yismailsaadelgedawy/PROJ515/Low noise small signal amplifier.asc

C1: cap; 3.2µ
C2: cap; 56p
C3: cap; 12.1µ
C4: cap; 100n
C5: cap; 10µ
C16: cap; 10µ
C17: cap; 30n
C18: cap; 30n
C19: cap; 30n
C20: cap; 30n
C21: cap; 30n
C22: cap; 30n
C23: cap; 100n
C24: cap; 100n
C25: cap; 10µ
C26: cap; 1µ
C27: cap; 1.5n
C28: cap; 1.5n
C29: cap; 1.5n
C30: cap; 1.5n
C31: cap; 1.5n
C32: cap; 1.5n
C33: cap; 1µ
C34: cap; 1µ
C35: cap; 1µ
C36: cap; 1µ
C37: cap; 0.1µ
C38: cap; 10n
C39: cap; 10n
C40: cap; 10n
C41: cap; 10n
C42: cap; 10n
C43: cap; 10n
C44: cap; 1µ
C45: cap; 1µ
C46: cap; 2.2n
C47: cap; 430p
C48: cap; 2.2n
C49: cap; 10n
C50: cap; 2.2n
C51: cap; 10n
D1: diode; RBR2LAM60A
D2: diode; RBR2LAM60A
D3: diode; RBR2LAM60A
R1: res; 100k
R2: res; 5k
R3: res; 100k
R4: res; 100k
R5: res; 2.5k
R6: res; 100k
R15: res; 100k
R16: res; 100k
R17: res; 4.99k
R18: res; 200k
R19: res; 10k
R20: res; 173k
R21: res; 106k
R22: res; 1.42k
R23: res; 346k
R24: res; 2.06k
R25: res; 202k
R26: res; 127k
R27: res; 2.47k
R28: res; 242k
R29: res; 191k
R30: res; 2.61k
R31: res; 210k
R32: res; 2.87k
R33: res; 10k
R34: res; 15.2k
R35: res; 1Meg
R36: res; 132k
R37: res; 70.3k
R38: res; 1.15k
R39: res; 264k
R40: res; 1.6k
R41: res; 156k
R42: res; 87k
R43: res; 1.98k
R44: res; 193k
R45: res; 37.1k
R46: res; 499
R47: res; 41.8k
R48: res; 562
R49: res; 200k
R50: res; 127k
R51: res; 42k
R52: res; 15.2k
R53: res; 1Meg
R54: res; 100k
R55: res; 175k
R56: res; 6.54k
R57: res; 255k
R58: res; 2.24k
R59: res; 387k
R60: res; 80.8k
R61: res; 4.31k
R62: res; 744k
R63: res; 35.3k
R64: res; 108k
R65: res; 52.5k
R67: res; 200k
R68: res; 15.2k
R69: res; 1Meg
R70: res; 80k
R71: res; 160k
R72: res; 90.4k
R73: res; 318k
R74: res; 145k
U2: MAX44246
U3: MAX9636
U5: AD8031
U6: MAX9638
U7: MAX9638
U8: MAX9638
U9: LT1018
U10: MAX9638
U11: MAX9638
U12: MAX9638
U13: LT1018
U14: MAX9638
U15: MAX9638
U16: MAX9638
U17: MAX9638
U18: MAX9638
U19: MAX9638
U20: LT1018
U21: MAX9638
U22: MAX9638
U23: MAX9638
U24: MAX9638
U25: MAX9638
U26: MAX9638
U27: MAX9638
V1: voltage; SINE(0 1 600); AC 1
V2: voltage; ""; AC 1
V4: voltage; SINE(0 1m 500); AC 1
V5: voltage; 3.3
Named nets: VA, Vin, 0, Vcc, Vref, Vout2, Venv2, Comp2out, env2_out, Vout, Venv1, Comp1out, Cref, Cref2, ADC_out, Vout3, Vout4, Vout5
.ac dec 10000 10 1000000
.tran 50m
Source and reference
U9 is TI TLV3201/2 comparator
U12 is TI TLV3201/2 comparator
6.11 kHz bandpass trigger
Lowpass amplifier gain stage 1: 32 dB, total: 58.5 dB
240 Hz bandpass trigger
ADC amplifier
U9 is TI TLV3201/2 comparator
420 Hz bandpass trigger
800 Hz anti-aliasing
450 Hz anti-aliasing
