yismailsaadelgedawy/PROJ515/thermocouple_PCB.kicad_pcb

## KiCad design thermocouple_PCB.kicad_pcb (2025-03-26)

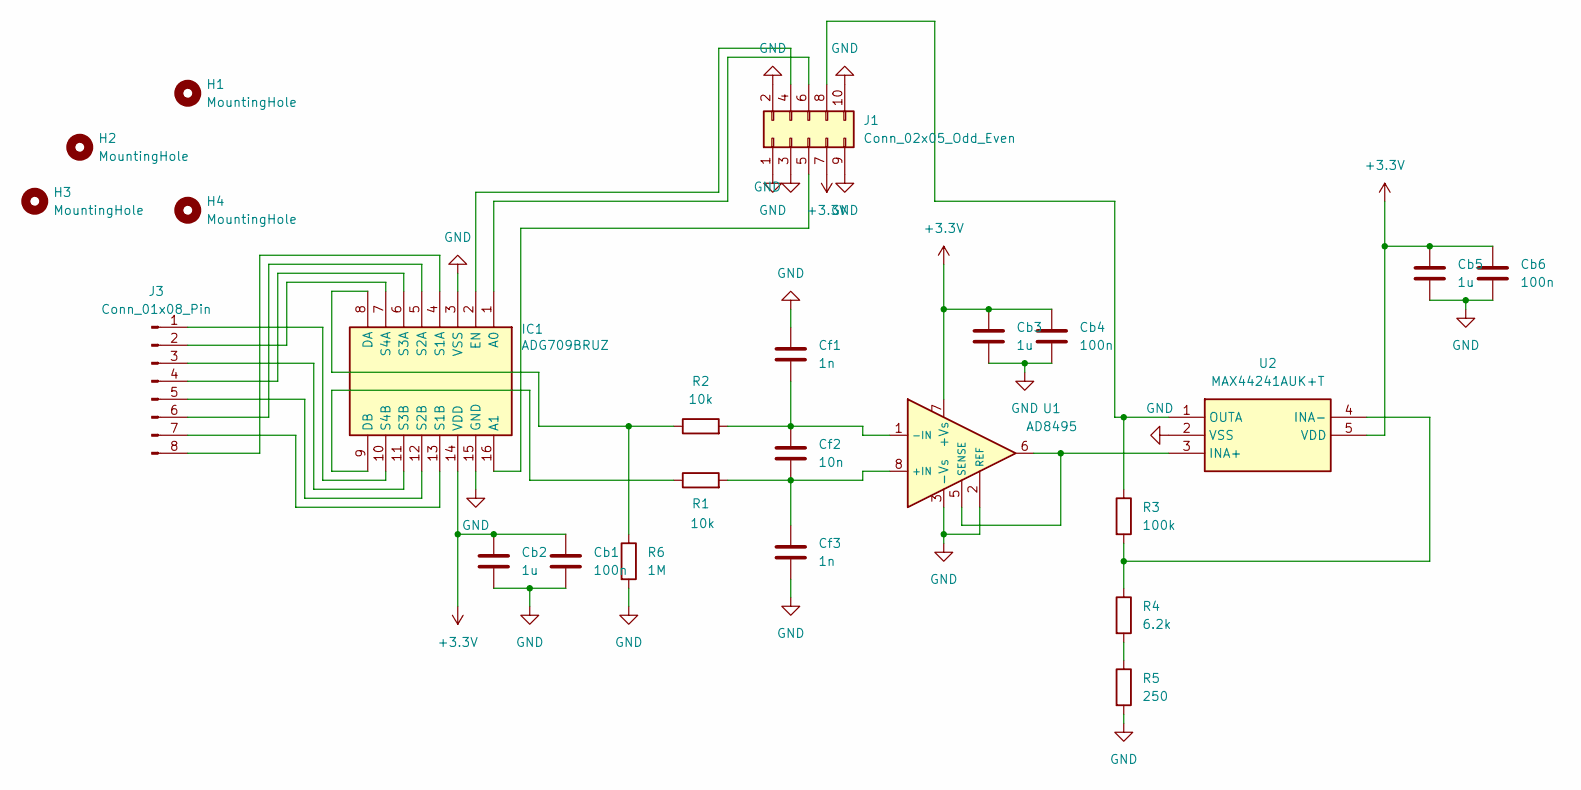
[picture p1: schematic thermocouple_PCB.kicad_sch]

Parts:
Cb1, Cb4, Cb6: 100n; C_0402_1005Metric
Cb2, Cb3, Cb5: 1u; C_0402_1005Metric
Cf1, Cf3: 1n; C_0603_1608Metric
Cf2: 10n; C_0603_1608Metric
H1, H2, H3, H4: MountingHole; MountingHole_2.2mm_M2_DIN965_Pad_TopBottom
IC1: ADG709BRUZ; TSSOP-16_4.4x5mm_P0.65mm; Manufacturer_Part_Number ADG709BRUZ; Mouser Part Number 584-ADG709BRUZ
J1: Conn_02x05_Odd_Even; PinHeader_2x05_P2.54mm_Horizontal
J3: Conn_01x08_Pin; PinHeader_1x08_P2.54mm_Horizontal
R1, R2: 10k; R_0402_1005Metric
R3: 100k; R_0402_1005Metric
R4: 6.2k; R_0603_1608Metric
R5: 250; R_0402_1005Metric
R6: 1M; R_0402_1005Metric
U1: AD8495; MSOP-8_3x3mm_P0.65mm
U2: MAX44241AUK+T; SOT-23-5; Manufacturer_Part_Number MAX44241AUK+T; Mouser Part Number 700-MAX44241AUK+T

Connections:
+3.3V: Cb1.1, Cb2.1, Cb3.1, Cb4.1, Cb5.1, Cb6.1, IC1.14 (VDD), J1.7, U1.7 (+Vs), U2.5 (VDD)
GND: Cb1.2, Cb2.2, Cb3.2, Cb4.2, Cb5.2, Cb6.2, Cf1.1, Cf3.2, IC1.3 (VSS), IC1.15 (GND), J1.1, J1.2, J1.3, J1.9, J1.10, R5.2, R6.2, U1.2 (REF), U1.3 (-Vs), U2.2 (VSS)
unnamed: IC1.1 (A0), J1.6
unnamed: IC1.16 (A1), J1.5
unnamed: IC1.8 (DA), R2.1, R6.1
unnamed: IC1.9 (DB), R1.1
unnamed: IC1.2 (EN), J1.4
unnamed: IC1.4 (S1A), J3.8
unnamed: IC1.13 (S1B), J3.7
unnamed: IC1.5 (S2A), J3.6
unnamed: IC1.12 (S2B), J3.5
unnamed: IC1.6 (S3A), J3.4
unnamed: IC1.11 (S3B), J3.3
unnamed: IC1.7 (S4A), J3.2
unnamed: IC1.10 (S4B), J3.1
unnamed: J1.8, R3.1, U2.1 (OUTA)
unnamed: R4.2, R5.1
unnamed: Cf2.2, Cf3.1, R1.2, U1.8 (+IN)
unnamed: Cf1.2, Cf2.1, R2.2, U1.1 (-IN)
unnamed: U1.5 (SENSE), U1.6, U2.3 (INA+)
unnamed: R3.2, R4.1, U2.4 (INA-)

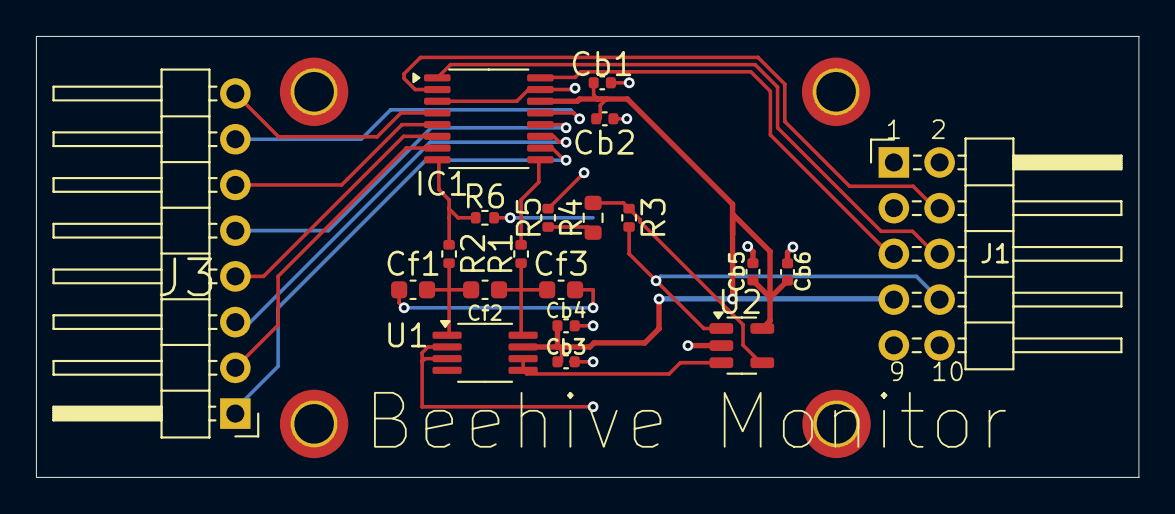
[picture p2: board thermocouple_PCB.kicad_pcb from above]

Board: 2 copper layers, 61.2 x 24.5 mm, 24 parts (0 on the bottom side), 21 nets.
