yismailsaadelgedawy/PROJ515/thermocouple_PCB/Beehive_Monitor_main_PCB/Beehive_Monitor_main_PCB.kicad_pcb

## KiCad design thermocouple_PCB/Beehive_Monitor_main_PCB/Beehive_Monitor_main_PCB.kicad_pcb (2025-03-11)

Schematic: Beehive_Monitor_main_PCB.kicad_sch

Parts:
5_V_PWR1, 12_V_PWR2: Conn_01x02_Pin; Molex_KK-254_AE-6410-02A_1x02_P2.54mm_Vertical
Accelerometer1: Conn_02x05_Odd_Even; PinHeader_2x05_P2.54mm_Vertical
C1: 22u; C_1206_3216Metric
C2, C11, C14, C25, C30, C35, C50, C51, C52, C101: 10u; C_0805_2012Metric
C3: 4.7u; C_1206_3216Metric
C4: 470n; C_0603_1608Metric
C5: 820p; C_0603_1608Metric_Pad1.08x0.95mm_HandSolder
C6: 68n; C_1206_3216Metric_Pad1.33x1.80mm_HandSolder
C7: 120p; C_0603_1608Metric_Pad1.08x0.95mm_HandSolder
C8, C9, C10, C18, C19, C20: 100u; C_1206_3216Metric
C12, C13, C24, C26, C32, C37, C41, C43, C45, C47, C49, C56, C80, C90, C92, C97, C98, C100, C103, C105, C107, C109, C114: 100n; C_0402_1005Metric
C15, C16, C17, C53, C54, C65, C72, C73, C74, C75, C76, C77: 15n; C_0805_2012Metric
C23, C40, C42, C44, C46, C48, C55, C57, C66, C78, C79, C81, C88, C89, C91, C93, C99, C102, C104, C106, C108, C110, C115: 1u; C_0402_1005Metric
C27, C33, C38: 3.3u; C_0603_1608Metric_Pad1.08x0.95mm_HandSolder
C28, C34, C39: 56p; C_0603_1608Metric_Pad1.08x0.95mm_HandSolder
C29, C31, C36: 2.2u; C_0603_1608Metric
C58, C59, C60, C61, C62, C63: 1.5n; C_0603_1608Metric
C64, C67, C69, C71: 1u; C_0402_1005Metric_Pad0.74x0.62mm_HandSolder
C68, C70: 100n; C_0402_1005Metric_Pad0.74x0.62mm_HandSolder
C82, C83, C84, C85, C86, C87, C111, C113, C116, C118: 10n; C_0603_1608Metric
C94, C96, C112, C117: 2.2n; C_0805_2012Metric
C95: 430p; C_0603_1608Metric_Pad1.08x0.95mm_HandSolder
Cboot1, Cboot5: 100n; C_0402_1005Metric
Css1, Css5: 2.2n; C_0805_2012Metric
D1, D2, D3, D4, D5, D7, D8: RBR2LAM60A; D_MELF
F1: Fuse; Fuseholder_Clip-5x20mm_Keystone_3517_Inline_P23.11x6.76mm_D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
IC1: LT6700HVCS6-3#PBF; TSOT-23-6; Manufacturer_Part_Number LT6700HVCS6-3#PBF
IC2, IC10: AD8226ARZ; SOIC-8_3.9x4.9mm_P1.27mm; Manufacturer_Part_Number AD8226ARZ; Mouser Part Number 584-AD8226ARZ
IC3, IC5: TPS54620RHLR; Texas_S-PVQFN-N14_ThermalVias; Manufacturer_Part_Number TPS54620RHLR; Mouser Part Number 595-TPS54620RHLR
IC4: AD8031ARTZ-R2; SOT-23-5; Manufacturer_Part_Number AD8031ARTZ-R2; Mouser Part Number 584-AD8031ARTZ-R2
IC6, IC7: MAX44246ASA+; MSOP-8_3x3mm_P0.65mm; Manufacturer_Part_Number MAX44246ASA+; Mouser Part Number 700-MAX44246ASA+
IC8: ADA4077-4ARZ; SOIC-14_3.9x8.7mm_P1.27mm; Manufacturer_Part_Number ADA4077-4ARZ; Mouser Part Number 584-ADA4077-4ARZ
IC9: SN74LV123ADRG4; TSSOP-16_4.4x5mm_P0.65mm; Manufacturer_Part_Number SN74LV123ADRG4; Mouser Part Number 595-SN74LV123ADRG4
IC11: TMUX1204DGSR; VSSOP-10_3x3mm_P0.5mm; Manufacturer_Part_Number TMUX1204DGSR; Mouser Part Number 595-TMUX1204DGSR
J1: Conn_02x08_Odd_Even; PinSocket_2x08_P2.54mm_Vertical_SMD
J2: Conn_02x10_Odd_Even; PinSocket_2x10_P2.54mm_Vertical_SMD
J3: Conn_02x15_Odd_Even; PinSocket_2x15_P2.54mm_Vertical_SMD
J4: Conn_02x17_Odd_Even; PinSocket_2x17_P2.54mm_Vertical_SMD
J5: Micro_SD_Card_Det_Hirose_DM3AT; microSD_HC_Hirose_DM3AT-SF-PEJM5
JP1: SolderJumper_2_Open; SolderJumper-2_P1.3mm_Open_RoundedPad1.0x1.5mm
JP3, JP4, JP5, JP7, JP8, JP9, JP10, JP11, JP12: SolderJumper_3_Bridged12; SolderJumper-3_P1.3mm_Bridged12_RoundedPad1.0x1.5mm
K2: HFD3_12-L2_257_; Relay_DPDT_Kemet_EC2_NU_DoubleCoil; Manufacturer_Part_Number HFD3/12-L2(257)
L1: 7443641000B; L_Wuerth_HCF-2818; Manufacturer_Part_Number 7443641000B; Mouser Part Number 710-7443641000B
L2: 22u; L_Wuerth_HCF-2818
L3: LMC555CMX_NOPB; SOIC-8_3.9x4.9mm_P1.27mm; Manufacturer_Part_Number LMC555CMX/NOPB; Mouser Part Number 926-LMC555CMX/NOPB
LCD_BTNs1: Conn_02x08_Odd_Even; PinHeader_2x08_P2.54mm_Vertical
LED_S1: Conn_02x05_Odd_Even; PinHeader_2x05_P2.54mm_Vertical
PE_9, PE_10, PE_15: SolderJumper_2_Open; SolderJumper-2_P1.3mm_Open_RoundedPad1.0x1.5mm
PF_14, PF_15: SolderJumper_2_Open; SolderJumper-2_P1.3mm_Open_RoundedPad1.0x1.5mm
PI_PWR1, PI_PWR2: Conn_01x02_Pin; Molex_KK-254_AE-6410-02A_1x02_P2.54mm_Vertical
PI_Ribbon1: Conn_02x05_Odd_Even; PinHeader_2x05_P2.54mm_Vertical
Q1, Q2, Q3, Q4, Q5, Q6, Q7: Q_NPN_BCE; SOT-23
Q8: PNP; SOT-23
Q9: FDS6681Z; SO-8_3.9x4.9mm_P1.27mm
R1, R3, R4, R17, R20, R28, R29, R30, R34, R35, R36, R39, R40, R41, R55, R72, R80, R87, R88, R105, R147, R148, R149, R500: 100k; R_0402_1005Metric
R2: 11.5k; R_0603_1608Metric_Pad0.98x0.95mm_HandSolder
R5, R73, R99, R103, R108, R123, R134, R140, R152, R169: 200; R_0402_1005Metric
R6, R15: 150k; R_0603_1608Metric
R7: 12k; R_0603_1608Metric_Pad0.98x0.95mm_HandSolder
R8, R119, R165, R175: 47k; R_0402_1005Metric
R9, R21, R44, R45, R96, R131, R168: 10k; R_0402_1005Metric
R10, R19: 3.9k; R_0603_1608Metric
R11: 330; R_0603_1608Metric
R12: 5.1k; R_0402_1005Metric
R13, R51: 150; R_0603_1608Metric
R14, R49, R65, R113, R129, R167: 12k; R_0603_1608Metric
R16: 909; R_0603_1608Metric_Pad0.98x0.95mm_HandSolder
R18, R89, R106, R151: 27k; R_0603_1608Metric
R22: 4.99k; R_0603_1608Metric
R23, R25, R42: 20k; R_0603_1608Metric_Pad0.98x0.95mm_HandSolder
R24, R26, R43: 5k; R_0603_1608Metric_Pad0.98x0.95mm_HandSolder
R27, R32, R37, R84, R92: 2.4k; R_0603_1608Metric
R31, R33, R38, R58, R68, R161, R172: 100; R_0603_1608Metric
R46: 1k; R_0402_1005Metric
R47, R116: 120k; R_0603_1608Metric
R48: 261k; R_0603_1608Metric_Pad0.98x0.95mm_HandSolder
R50, R81, R101, R157: 3k; R_0603_1608Metric
R52: 68.1k; R_0603_1608Metric_Pad0.98x0.95mm_HandSolder
R53: 37.4k; R_0603_1608Metric_Pad0.98x0.95mm_HandSolder
R54: 499; R_0603_1608Metric_Pad0.98x0.95mm_HandSolder
R56, R66, R82: 1.5k; R_0402_1005Metric
R57, R155, R160, R171: 2.2k; R_0603_1608Metric
R59: 56k; R_0603_1608Metric
R60, R162, R173: 75k; R_0603_1608Metric
R61, R90, R104: 470; R_0402_1005Metric
R62: 191k; R_0603_1608Metric_Pad0.98x0.95mm_HandSolder
R63: 41.7k; R_0603_1608Metric_Pad0.98x0.95mm_HandSolder
R64: 562; R_0603_1608Metric_Pad0.98x0.95mm_HandSolder
R67, R86, R91, R114, R164: 2k; R_0603_1608Metric
R69, R85, R95, R97, R132: 200k; R_0603_1608Metric
R70, R98, R133: 15k; R_0402_1005Metric
R71, R100, R135, R150: 1M; R_0402_1005Metric
R74, R111, R159, R163, R170, R174: 33k; R_0603_1608Metric
R75: 140k; R_0603_1608Metric_Pad0.98x0.95mm_HandSolder
R76: 1.2k; R_0603_1608Metric
R77, R145: 220; R_0603_1608Metric
R78: 316k; R_0603_1608Metric_Pad0.98x0.95mm_HandSolder
R79: 30k; R_0603_1608Metric
R83: 560; R_0603_1608Metric
R93, R136, R137: 220k; R_0603_1608Metric
R94, R156: 22k; R_0603_1608Metric
R102: 91k; R_0603_1608Metric_Pad0.98x0.95mm_HandSolder
R107: 6.34k; R_0603_1608Metric_Pad0.98x0.95mm_HandSolder
R109: 255k; R_0603_1608Metric_Pad0.98x0.95mm_HandSolder
R110, R141: 68k; R_0603_1608Metric
R112: 82k; R_0603_1608Metric
R115: 249; R_0603_1608Metric_Pad0.98x0.95mm_HandSolder
R117: 300k; R_0603_1608Metric
R118: 330k; R_0603_1608Metric
R120, R125, R126, R127, R138, R139, R142, R143: 4.7k; R_0402_1005Metric
R121, R130: 270; R_0603_1608Metric
R122: 80.6; R_0603_1608Metric_Pad0.98x0.95mm_HandSolder
R124: 4.32k; R_0603_1608Metric_Pad0.98x0.95mm_HandSolder
R128: 732k; R_0603_1608Metric_Pad0.98x0.95mm_HandSolder
R144, R146: 120; R_0402_1005Metric
R154: 6.2k; R_0603_1608Metric
R158: 18k; R_0603_1608Metric
R166, R176: 5.6k; R_0603_1608Metric
RV1, RV2: 5k; Potentiometer_Bourns_3296Y_Vertical
RV3, RV10, RV11: 50k; Potentiometer_Bourns_3296W_Vertical
RV4, RV5, RV6, RV7, RV8: 200k; Potentiometer_Bourns_3296W_Vertical
RV9: 25k; Potentiometer_Bourns_3296W_Vertical
TC_1_2, TC_3_4: Conn_02x07_Odd_Even; PinHeader_2x07_P2.54mm_Vertical
TP_1, TP_2, TP_3, TP_4, TP_5, TP_6, TP_7, TP_8, TP_9, TP_10: Conn_01x01_Pin; PinHeader_1x01_P2.54mm_Vertical
U1, U3, U4, U6, U7, U8: Opamp_Quad; SOIC-14_3.9x8.7mm_P1.27mm
U2, U5: TLV3201/2; SOIC-8_3.9x4.9mm_P1.27mm
mic_1_LDR1: Conn_01x04_Pin; Molex_KK-254_AE-6410-04A_1x04_P2.54mm_Vertical
mic_2: Conn_01x02_Pin; Molex_KK-254_AE-6410-02A_1x02_P2.54mm_Vertical

Connections:
3.3_V_out: C18.1, C19.1, C20.1, J1.8, K2.4 (COM_1), L2.2, LED_S1.10, PI_PWR2.1, R18.1; also elsewhere on the board
5_V: 5_V_PWR1.1, C8.1, C9.1, C10.1, C99.1, C100.1, D7.1 (K), D8.1 (K), IC9.2 (1B), IC9.3 (1~CLR), IC9.11 (2~CLR), IC9.16 (VCC), JP1.1 (A), K2.1 (SET+), K2.6 (RESET+), L1.1, LED_S1.4, LED_S1.6, PI_PWR1.1, Q8.3 (E), R8.1, R131.1, R136.1, R137.2, R144.1; also elsewhere on the board
6.11_kHz_AA_out_MCU: C63.2, D1.2 (A), J3.25, R63.2, R67.2, U1.14
6.11_kHz_out_MCU: J2.19, PI_Ribbon1.9, R71.2, U2.1; also elsewhere on the board
240_Hz_out_MCU: J2.11, PI_Ribbon1.1, R100.2, U2.7; also elsewhere on the board
555_out: L3.3 (OUTPUT), R146.1
Acc_420_Hz_out_MCU: J2.9, R135.2, U5.1
Acc_AA_out_to_MCU: C96.2, J3.2, U6.8, U6.9 (-)
Acc_sig_in: Accelerometer1.3, C35.1, C36.1; also elsewhere on the board
Acc_tmp: Accelerometer1.8, J4.12; also elsewhere on the board
BTN_1: J3.18, LCD_BTNs1.5; also elsewhere on the board
BTN_2: J3.20, LCD_BTNs1.3; also elsewhere on the board
BTN_3: J3.22, LCD_BTNs1.1; also elsewhere on the board
Cref: R72.1, RV7.3, TP_8.1, U2.2 (-), U2.6 (-)
Cref2: R167.1, RV8.3, TP_9.1, U5.2 (-)
D_4: J3.7, LCD_BTNs1.13; also elsewhere on the board
D_5: J3.5, LCD_BTNs1.11; also elsewhere on the board
D_6: J3.3, LCD_BTNs1.9; also elsewhere on the board
D_7: J3.1, LCD_BTNs1.7; also elsewhere on the board
EN: J4.20, LCD_BTNs1.12; also elsewhere on the board
Front_mic_pin: C30.1, C31.1, mic_1_LDR1.1; also elsewhere on the board
GND: 5_V_PWR1.2, 12_V_PWR2.2, Accelerometer1.9, C1.2, C2.2, C3.2, C4.2, C5.2, C6.2, C7.2, C8.2, C9.2, C10.2, C11.2, C12.2, C13.2, C14.2, C18.2, C19.2, C20.2, C23.2, C24.2, C26.2, C27.2, C32.2, C33.2, C37.2, C38.2, C40.2, C41.2, C42.2, C43.2, C44.2, C45.2, C46.2, C47.2, C48.2, C49.2, C50.2, C51.2, C52.2, C55.2, C56.2, C57.1, C64.2, C66.2, C67.2, C68.2, C69.2, C70.2, C71.1, C78.2, C79.2, C80.2, C81.1, C88.2, C89.2, C90.2, C91.2, C92.2, C99.2, C100.2, C101.2, C102.2, C103.2, C104.2, C105.2, C106.2, C107.2, C108.2, C109.2, C114.2, Css1.2, Css5.2, IC1.2 (GND), IC2.5 (-VS), IC2.6 (REF), IC3.2 (GND_1), IC3.3 (GND_2), IC3.15 (EP), IC4.2 (-VS), IC5.2 (GND_1), IC5.3 (GND_2), IC5.15 (EP), IC6.4 (GND), IC7.4 (GND), IC7.5 (INB+), IC8.11 (V-), IC9.8 (GND), IC9.9 (2~A), IC10.5 (-VS), IC10.6 (REF), IC11.3 (GND), J1.12, J1.14, J2.7, J3.11, J3.24, J4.6, J4.18, J4.21, J4.28, J5.6 (VSS), J5.11 (SHIELD), JP3.1 (A), JP4.1 (A), JP5.1 (A), JP7.1 (A), JP8.1 (A), JP9.1 (A), JP10.1 (A), JP11.1 (A), JP12.1 (A), L3.1 (GND), LCD_BTNs1.16, PI_PWR1.2, PI_PWR2.2, Q1.3 (E), Q2.3 (E), Q4.3 (E), Q5.3 (E), Q6.3 (E), R7.1, R9.2, R14.1, R20.2, R21.2, R29.2, R35.2, R40.2, R69.2, R97.2, R132.2, R145.2, R148.2, R152.2, RV1.2, RV2.2, RV7.2, RV8.2, RV9.2, RV11.2, TC_1_2.2, TC_1_2.13, TC_3_4.2, TC_3_4.13, U1.11 (V-), U2.4 (V-), U3.11 (V-), U4.11 (V-), U5.4 (V-), U6.11 (V-), U6.12 (+), U7.11 (V-), U7.12 (+), U8.11 (V-), U8.12 (+), mic_1_LDR1.2, mic_2.2; also elsewhere on the board
IC6_inA+: C32.1, C33.1, IC6.3 (INA+), R34.2, R35.1
IC6_inA-: C34.1, IC6.2 (INA-), R33.2, R36.1
IC6_inB+: C26.1, C27.1, IC6.5 (INB+), R28.2, R29.1
IC6_inB-: C28.1, IC6.6 (INB-), R30.1, R31.2
IC6_outA: C34.2, IC6.1 (OUTA), IC8.3 (+IN_A), R36.2
IC6_outB: C28.2, IC6.7 (OUTB), IC8.5 (+IN_B), R30.2
IC7_inA+: C37.1, C38.1, IC7.3 (INA+), R39.2, R40.1
IC7_inA-: C39.1, IC7.2 (INA-), R38.2, R41.1
IC7_outA: C39.2, IC7.1 (OUTA), IC8.10 (+IN_C), R41.2
LCD_B/light: J3.30, LCD_BTNs1.2; also elsewhere on the board
LDR_TRIG_out_MCU: J2.17, PI_Ribbon1.7, R150.2, U5.7; also elsewhere on the board
LDR_out_MCU: IC10.7 (VOUT), J3.12, R151.1, TP_10.1
LDR_pin_1: Accelerometer1.2, C23.1, C24.1, C40.1, C41.1, C42.1, C43.1, C44.1, C45.1, C48.1, C49.1, C55.1, C56.1, C66.1, C67.1, C68.1, C69.1, C70.1, C79.1, C80.1, C89.1, C90.1, C91.1, C92.1, C104.1, C105.1, C106.1, C107.1, C108.1, C109.1, C114.1, IC2.8 (+VS), IC4.5 (+VS), IC6.8 (VDD), IC7.8 (VDD), IC8.4 (V+), IC10.8 (+VS), IC11.5 (EN), IC11.6 (VDD), IC11.8 (D), J5.4 (VDD), K2.3 (NC_1), LCD_BTNs1.4, LCD_BTNs1.6, LCD_BTNs1.8, LCD_BTNs1.10, R4.1, R17.1, R28.1, R34.1, R39.1, R72.2, R110.2, R147.1, R149.1, TC_1_2.5, TC_1_2.10, TC_3_4.5, TC_3_4.10, U1.4 (V+), U2.8 (V+), U3.4 (V+), U4.4 (V+), U5.8 (V+), U6.4 (V+), U7.4 (V+), U8.4 (V+), mic_1_LDR1.3; also elsewhere on the board
LDR_pin_2: IC10.4 (+IN), RV9.1, TP_7.1, mic_1_LDR1.4; also elsewhere on the board
LNA_Acc_out: IC8.8 (OUT_C), RV6.1, TP_6.1, U4.3 (+), U6.3 (+)
LNA_MF_out: IC8.1 (OUT_A), R44.1, RV4.1, TP_4.1, U1.3 (+), U3.3 (+), U8.3 (+)
LNA_MR_out: IC8.7 (OUT_B), RV5.1, TP_5.1, U7.3 (+)
MCU_LED_IN: J3.21, R120.1, R125.1
MCU_TC_add_0: J1.13, TC_1_2.1, TC_1_2.14, TC_3_4.1, TC_3_4.14
MCU_TC_add_1: J1.15, TC_1_2.4, TC_1_2.11, TC_3_4.4, TC_3_4.11
MCU_TC_add_2: IC11.1 (A0), J3.26
MCU_TC_add_3: IC11.10 (A1), J3.28
M_LED_1_cathode: LED_S1.3, R121.1; also elsewhere on the board
M_LED_2_cathode: LED_S1.5, R130.1; also elsewhere on the board
Maintainance _int: J4.1, LED_S1.9, PI_Ribbon1.10; also elsewhere on the board
Mic_F_AA_out_to_MCU: C113.2, J3.4, U8.8, U8.9 (-)
Mic_R_AA_out_to_MCU: C118.2, J3.6, U7.8, U7.9 (-)
Mic_out_to_AA: IC8.14 (OUT_D), R45.1
unnamed: 12_V_PWR2.1, F1.1
unnamed: C4.1, R16.2
unnamed: C6.1, R11.2
unnamed: C15.1, C16.1, C76.1, C77.1, R89.1, R90.2
unnamed: C17.1, C53.1, C74.1, C75.1, R81.2, R82.1
unnamed: C17.2, C75.2, R86.2, R87.1, R88.2, U3.8
unnamed: C25.2, C29.2, R27.1
unnamed: C30.2, C31.2, R32.1
unnamed: C35.2, C36.2, R37.1
unnamed: C50.1, R24.2
unnamed: C51.1, R26.2
unnamed: C52.1, R43.2
unnamed: C54.1, C65.1, C72.1, C73.1, R75.2, R76.1
unnamed: C58.1, C59.1, R46.1, R47.2
unnamed: C59.2, R50.1, R52.1, U1.7
unnamed: C60.1, C61.1, R56.1, R57.2
unnamed: C61.2, R53.1, R59.2, R60.2, U1.8
unnamed: C62.1, C63.1, R61.2, R65.1
unnamed: C65.2, C73.2, R79.1, R80.1, U3.7
unnamed: C82.1, C83.1, R106.2, R107.1
unnamed: C83.2, R109.1, R111.1, U4.7
unnamed: C84.1, C85.1, R113.2, R114.1
unnamed: C85.2, R119.2, R122.2, U4.8
unnamed: C86.1, C87.1, R123.1, R124.2
unnamed: C96.1, R117.1, R157.2
unnamed: C113.1, R163.2, R165.1
unnamed: C118.1, R174.2, R175.1
unnamed: C64.1, D1.1 (K), R69.1, R70.1
unnamed: C16.2, C77.2, D2.2 (A), R94.2, R96.2, U3.14
unnamed: C78.1, D2.1 (K), R97.1, R98.1
unnamed: C87.2, D3.2 (A), R129.2, U4.14
unnamed: C88.1, D3.1 (K), R132.1, R133.1
unnamed: D5.2 (A), R146.2
unnamed: D7.2 (A), K2.12 (SET-), Q6.2 (C)
unnamed: D8.2 (A), K2.7 (RESET-), Q5.2 (C)
unnamed: IC1.3 (+INA), R13.2, RV1.3
unnamed: IC1.4 (+INB), R3.2, RV2.3
unnamed: IC2.2 (RG_1), RV3.2
unnamed: IC2.3 (RG_2), RV3.1
unnamed: Cboot5.1, IC3.13 (BOOT)
unnamed: C7.1, IC3.8 (COMP), R10.1
unnamed: Cboot5.2, IC3.11 (PH_1), IC3.12 (PH_2), L1.2
unnamed: IC3.1 (RT/CLK), R6.2
unnamed: Css5.1, IC3.9 (SS/TR)
unnamed: C11.1, C12.1, IC4.3 (+IN), R17.2, R20.1
unnamed: IC4.4 (-IN), R22.1
unnamed: Cboot1.1, IC5.13 (BOOT)
unnamed: C5.1, IC5.8 (COMP), R16.1
unnamed: Cboot1.2, IC5.11 (PH_1), IC5.12 (PH_2), L2.1
unnamed: IC5.1 (RT/CLK), R15.2
unnamed: Css1.1, IC5.9 (SS/TR)
unnamed: IC7.6 (INB-), IC7.7 (OUTB)
unnamed: IC8.2 (-IN_A), R23.2, R24.1
unnamed: IC8.6 (-IN_B), R25.2, R26.1
unnamed: IC8.9 (-IN_C), R42.2, R43.1
unnamed: IC8.13 (-IN_D), R44.2, R45.2
unnamed: C98.1, IC9.14 (1CEXT)
unnamed: C98.2, IC9.15 (1REXT/CEXT), R137.1
unnamed: IC9.1 (1~A), IC9.10 (2B), Q3.2 (C), R131.2
unnamed: C97.2, IC9.6 (2CEXT)
unnamed: C97.1, IC9.7 (2REXT/CEXT), R136.2
unnamed: IC10.1 (-IN), R147.2, R148.1
unnamed: IC10.2 (RG_1), RV10.1
unnamed: IC10.3 (RG_2), RV10.2
unnamed: J1.10, JP1.2 (B)
unnamed: J4.3, PE_9.1 (A)
unnamed: J4.7, PF_14.1 (A)
unnamed: J4.11, PF_15.1 (A)
unnamed: J4.23, PE_10.1 (A)
unnamed: J4.29, PE_15.1 (A)
unnamed: C110.2, JP3.2 (C)
unnamed: C111.2, JP4.2 (C)
unnamed: C115.2, JP5.2 (C)
unnamed: C112.2, JP7.2 (C)
unnamed: C116.2, JP8.2 (C)
unnamed: C117.2, JP9.2 (C)
unnamed: C93.2, JP10.2 (C)
unnamed: C94.2, JP11.2 (C)
unnamed: C95.2, JP12.2 (C)
unnamed: L3.7 (DISCHARGE), R141.1, R169.2
unnamed: C101.1, L3.2 (~TRIGGER), L3.6 (THRESHOLD), R164.2
unnamed: Q1.1 (B), R120.2
unnamed: Q1.2 (C), R121.2
unnamed: Q2.1 (B), R126.2
unnamed: Q2.2 (C), R130.2
unnamed: Q3.1 (B), R125.2
unnamed: Q3.3 (E), Q4.2 (C)
unnamed: Q4.1 (B), R127.2
unnamed: Q5.1 (B), R139.2
unnamed: Q6.1 (B), R138.2
unnamed: Q7.1 (B), R142.2
unnamed: Q7.2 (C), R144.2
unnamed: Q8.2 (B), R143.2
unnamed 144: F1.2, Q9.1 (D); also elsewhere on the board
unnamed: Q9.2 (G), R152.1
unnamed: R6.1, R7.2
unnamed: R10.2, R11.1
unnamed: R8.2, R12.1
unnamed: R5.1, R12.2
unnamed: R2.2, R13.1
unnamed: R14.2, R15.1
unnamed: R18.2, R19.1
unnamed: R23.1, RV4.2
unnamed: R25.1, RV5.2
unnamed: R27.2, R31.1
unnamed: R32.2, R33.1
unnamed: R37.2, R38.1
unnamed: R42.1, RV6.2
unnamed: R46.2, R51.2
unnamed: R47.1, R49.2
unnamed: R48.1, R50.2
unnamed: R52.2, R57.1
unnamed: R55.2, R59.1
unnamed: R56.2, R58.1
unnamed: R60.1, R65.2
unnamed: R61.1, R66.2
unnamed: R62.2, R67.1
unnamed: R63.1, R68.2
unnamed: R70.2, R73.1
unnamed: R74.2, R75.1
unnamed: R76.2, R77.2
unnamed: R78.1, R79.2
unnamed: R82.2, R83.1
unnamed: R85.2, R86.1
unnamed: R88.1, R89.2
unnamed: R90.1, R91.2
unnamed: R93.2, R94.1
unnamed: R95.2, R96.1
unnamed: R98.2, R99.1
unnamed: R80.2, R101.1
unnamed: R81.1, R101.2
unnamed: R87.2, R102.1
unnamed: R84.2, R103.1
unnamed: R92.1, R104.2
unnamed: R105.2, R106.1
unnamed: R107.2, R108.2
unnamed: R110.1, R167.2
unnamed: R111.2, R113.1
unnamed: R112.2, R154.1
unnamed: R114.2, R115.1
unnamed: R116.2, R156.1
unnamed: R117.2, R158.1
unnamed: R118.2, R168.1
unnamed: R119.1, R168.2
unnamed: R122.1, R123.2
unnamed: R128.2, R129.1
unnamed: R133.2, R134.1
unnamed: R140.2, R169.1
unnamed: R141.2, R164.1
unnamed: R154.2, R155.1
unnamed: R156.2, R157.1
unnamed: R159.2, R160.1
unnamed: R160.2, R161.1
unnamed: R162.2, R163.1
unnamed: R165.2, R166.1
unnamed: R170.2, R171.1
unnamed: R171.2, R172.1
unnamed: R173.2, R174.1
unnamed: R175.2, R176.1
unnamed: C57.2, R49.1, U1.1, U1.2 (-)
unnamed: C58.2, R48.2, U1.6 (-)
unnamed: R53.2, R54.1, U1.10 (+)
unnamed: C60.2, R55.1, U1.9 (-)
unnamed: R64.2, R68.1, U1.12 (+)
unnamed: C62.2, R62.1, U1.13 (-)
unnamed: R71.1, R73.2, U2.3 (+)
unnamed: R99.2, R100.1, U2.5 (+)
unnamed: C71.2, R74.1, U3.1, U3.2 (-)
unnamed: C54.2, C72.2, R78.2, U3.6 (-)
unnamed: R84.1, R102.2, U3.10 (+)
unnamed: C53.2, C74.2, R85.1, U3.9 (-)
unnamed: R92.2, R95.1, U3.12 (+)
unnamed: C15.2, C76.2, R93.1, U3.13 (-)
unnamed: C81.2, R105.1, U4.1, U4.2 (-)
unnamed: C82.2, R109.2, U4.6 (-)
unnamed: C84.2, R118.1, U4.9 (-)
unnamed: C86.2, R128.1, U4.13 (-)
unnamed: R134.2, R135.1, U5.3 (+)
unnamed: R150.1, R151.2, U5.5 (+)
unnamed: R149.2, RV11.1, U5.6 (-)
unnamed: C93.1, R112.1, U6.1, U6.2 (-)
unnamed: C94.1, R155.2, U6.5 (+)
unnamed: R116.1, U6.6 (-), U6.7
unnamed: C95.1, R158.2, U6.10 (+)
unnamed: U6.13 (-), U6.14
unnamed: C115.1, R170.1, U7.1, U7.2 (-)
unnamed: C116.1, R172.2, U7.5 (+)
unnamed: R173.1, U7.6 (-), U7.7
unnamed: C117.1, R176.2, U7.10 (+)
unnamed: U7.13 (-), U7.14
unnamed: C110.1, R159.1, U8.1, U8.2 (-)
unnamed: C111.1, R161.2, U8.5 (+)
unnamed: R162.1, U8.6 (-), U8.7
unnamed: C112.1, R166.2, U8.10 (+)
unnamed: U8.13 (-), U8.14
PI_CS: J4.5, PI_Ribbon1.8; also elsewhere on the board
PI_LED_IN: PI_Ribbon1.3, R126.1, R127.1; also elsewhere on the board
PI_MISO: J4.9, PI_Ribbon1.6; also elsewhere on the board
PI_MOSI: J4.27, PI_Ribbon1.2; also elsewhere on the board
PI_SCLK: J4.25, PI_Ribbon1.4; also elsewhere on the board
Pwr_LED_Anode: D4.1 (K), D5.1 (K), LED_S1.2; also elsewhere on the board
Pwr_LED_Cathode: LED_S1.1, R145.1; also elsewhere on the board
RS: J4.24, LCD_BTNs1.14; also elsewhere on the board
RW: J4.22, LCD_BTNs1.15; also elsewhere on the board
Rear_mic_pin: C25.1, C29.1, mic_2.1; also elsewhere on the board
Relay_close: IC9.5 (2Q), R139.1
Relay_open: IC9.13 (1Q), R138.1
SD_CS: J2.14, J5.2 (DAT3/CD)
SD_MISO: J2.20, J5.7 (DAT0)
SD_MOSI: J2.16, J5.3 (CMD)
SD_SCLK: J2.18, J5.5 (CLK)
SD__detect: J4.16, J5.9 (DET_B), J5.10 (DET_A)
TC_EN_1: IC11.2 (S1), TC_1_2.3
TC_EN_2: IC11.9 (S2), TC_1_2.12
TC_EN_3: IC11.4 (S3), TC_3_4.3
TC_EN_4: IC11.7 (S4), TC_3_4.12
TC_Sig_1: J3.10, TC_1_2.6, TC_1_2.9, TC_3_4.6, TC_3_4.9
V_555: C102.1, C103.1, L3.4 (~RESET), L3.8 (V+), Q8.1 (C), R140.1
V_LED: D4.2 (A), Q7.3 (E)
Vcharge_MCU: IC2.7 (VOUT), J3.8, TP_3.1
Ven: IC1.6 (OUTB), IC3.10 (EN), IC5.10 (EN), R500.2, TP_1.1
Vref: C13.1, C14.1, IC2.4 (+IN), IC4.1 (VOUT), IC8.12 (+IN_D), JP3.3 (B), JP4.3 (B), JP5.3 (B), JP7.3 (B), JP8.3 (B), JP9.3 (B), JP10.3 (B), JP11.3 (B), JP12.3 (B), R22.2, R51.1, R54.2, R58.2, R64.1, R66.1, R77.1, R83.2, R91.1, R103.2, R104.1, R108.1, R115.2, R124.1, U1.5 (+), U3.5 (+), U4.5 (+), U4.10 (+), U4.12 (+)
Vreg_in: C1.1, C2.1, C3.1, C46.1, C47.1, IC1.5 (VS), IC3.4 (PVIN_1), IC3.5 (PVIN_2), IC3.6 (VIN), IC5.4 (PVIN_1), IC5.5 (PVIN_2), IC5.6 (VIN), Q9.3 (S), R1.1, R3.1
Vsens_3.3: IC5.7 (VSENSE), R19.2, R21.1
Vsens_5: IC3.7 (VSENSE), R5.2, R9.1
Vt_bat_trig_MCU: IC1.1 (OUTA), J2.15, PI_Ribbon1.5, R4.2, R142.1, R143.1, TP_2.1; also elsewhere on the board
Vtest: IC2.1 (-IN), R1.2, R2.1, R500.1

Notes on the sheet:
consider changing R2 for pot?
3.3 V regulator
240 Hz bandpass trigger
10 uH
6.11 kHz bandpass trigger
Colour code: Blue GPIO pin orange external componant wire cyan interrupt pin magenta ADC pin
Input and charge monitoring
800 Hz AA filter
Maintenance circuit
Power LED circuit
RS supplied L1
Reference voltage
LDR circuit
450 Hz AA filter
Farnell supplied C6 C7 L2 R2 R16 R48 R52 R53 R54 C5 C23 C28 R62 R75 R78 R107 R109 R118 R122 R128
420 Hz bandpass trigger
Microphone and accelerometer amplifiers
Thermocouple frame selection
5 V regulator

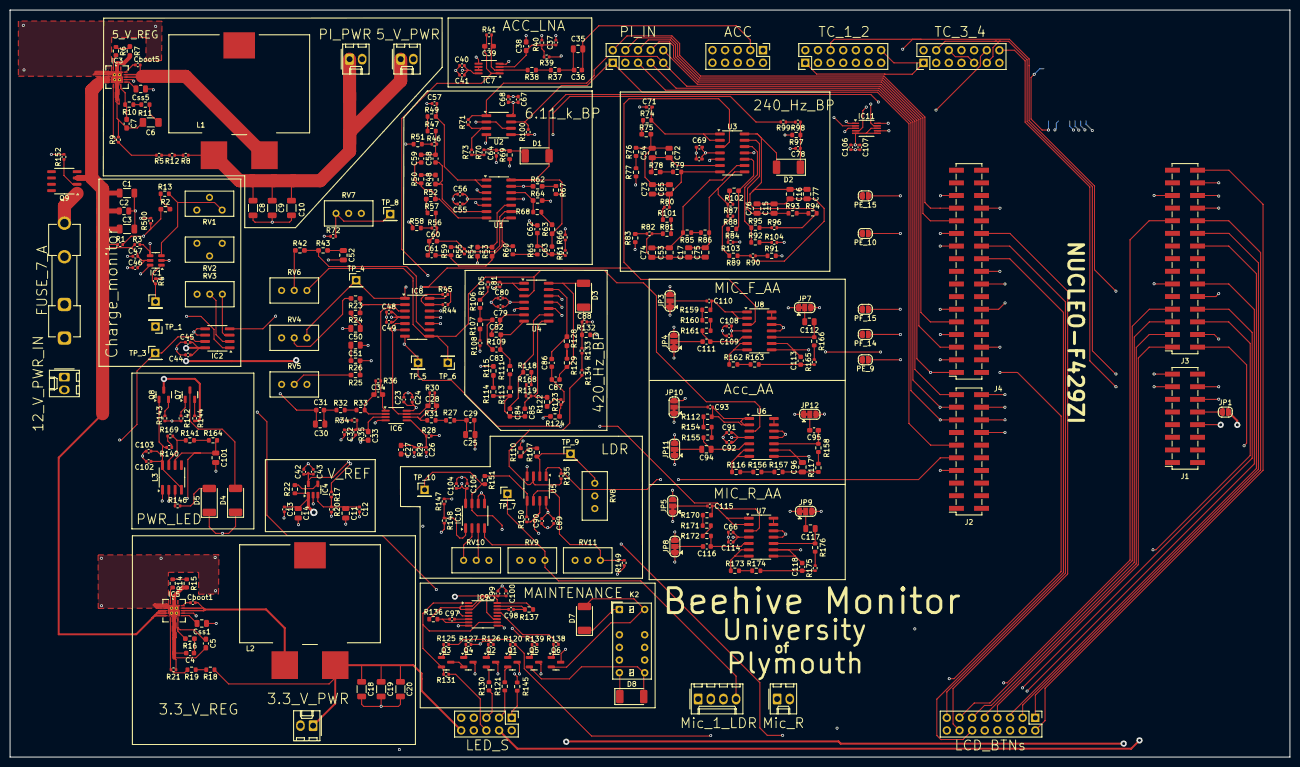
[picture p3: board Beehive_Monitor_main_PCB.kicad_pcb from above]

Board: 4 copper layers, 257.2 x 150.1 mm, 389 parts (1 on the bottom side), 277 nets.

Other parts of the board:
3.3_V_PWR, 5_V_PWR, 12_V_PWR_IN: Conn_01x02_Pin; Molex_KK-254_AE-6410-02A_1x02_P2.54mm_Vertical
ACC: Conn_02x05_Odd_Even; PinHeader_2x05_P2.54mm_Vertical
FUSE_7_A: Fuse; Fuseholder_Clip-5x20mm_Keystone_3517_Inline_P23.11x6.76mm_D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
LCD_BTNs: Conn_02x08_Odd_Even; PinHeader_2x08_P2.54mm_Vertical
LED_S: Conn_02x05_Odd_Even; PinHeader_2x05_P2.54mm_Vertical
Mic_1_LDR: Conn_01x04_Pin; Molex_KK-254_AE-6410-04A_1x04_P2.54mm_Vertical
Mic_R: Conn_01x02_Pin; Molex_KK-254_AE-6410-02A_1x02_P2.54mm_Vertical
PI_IN: Conn_02x05_Odd_Even; PinHeader_2x05_P2.54mm_Vertical
PI_PWR: Conn_01x02_Pin; Molex_KK-254_AE-6410-02A_1x02_P2.54mm_Vertical

Their connections:
3.3_V_out: 3.3_V_PWR.1, LED_S.10; also elsewhere on the board
5_V: 5_V_PWR.1, LED_S.4, LED_S.6, PI_PWR.1; also elsewhere on the board
6.11_kHz_out_MCU: PI_IN.9; also elsewhere on the board
12 V_in: 12_V_PWR_IN.1, FUSE_7_A.1
240_Hz_out_MCU: PI_IN.1; also elsewhere on the board
Acc_sig_in: ACC.3; also elsewhere on the board
Acc_tmp: ACC.8; also elsewhere on the board
BTN_1: LCD_BTNs.5; also elsewhere on the board
BTN_2: LCD_BTNs.3; also elsewhere on the board
BTN_3: LCD_BTNs.1; also elsewhere on the board
D_4: LCD_BTNs.13; also elsewhere on the board
D_5: LCD_BTNs.11; also elsewhere on the board
D_6: LCD_BTNs.9; also elsewhere on the board
D_7: LCD_BTNs.7; also elsewhere on the board
EN: LCD_BTNs.12; also elsewhere on the board
Front_mic_pin: Mic_1_LDR.1; also elsewhere on the board
GND: 3.3_V_PWR.2, 5_V_PWR.2, 12_V_PWR_IN.2, ACC.9, LCD_BTNs.16, Mic_1_LDR.2, Mic_R.2, PI_PWR.2; also elsewhere on the board
LCD_B/light: LCD_BTNs.2; also elsewhere on the board
LDR_TRIG_out_MCU: PI_IN.7; also elsewhere on the board
LDR_pin_1: ACC.2, LCD_BTNs.4, LCD_BTNs.6, LCD_BTNs.8, LCD_BTNs.10, Mic_1_LDR.3; also elsewhere on the board
LDR_pin_2: Mic_1_LDR.4; also elsewhere on the board
M_LED_1_cathode: LED_S.3; also elsewhere on the board
M_LED_2_cathode: LED_S.5; also elsewhere on the board
Maintainance _int: LED_S.9, PI_IN.10; also elsewhere on the board
unnamed 144: FUSE_7_A.2; also elsewhere on the board
PI_CS: PI_IN.8; also elsewhere on the board
PI_LED_IN: PI_IN.3; also elsewhere on the board
PI_MISO: PI_IN.6; also elsewhere on the board
PI_MOSI: PI_IN.2; also elsewhere on the board
PI_SCLK: PI_IN.4; also elsewhere on the board
Pwr_LED_Anode: LED_S.2; also elsewhere on the board
Pwr_LED_Cathode: LED_S.1; also elsewhere on the board
RS: LCD_BTNs.14; also elsewhere on the board
RW: LCD_BTNs.15; also elsewhere on the board
Rear_mic_pin: Mic_R.1; also elsewhere on the board
Vt_bat_trig_MCU: PI_IN.5; also elsewhere on the board
