yismailsaadelgedawy/PROJ515/(commit log)

2025-03-03 added pin mappings list
    [Pin Mappings.xlsx]
2025-03-03 Update Pin Mappings.xlsx
    [Pin Mappings.xlsx]
2025-03-09 PCB files added
    [Beehive_Monitor_main_PCB.kicad_pcb, Beehive_Monitor_main_PCB.kicad_sch, thermocouple_PCB.kicad_pcb, thermocouple_PCB.kicad_sch]
2025-03-11 latest pcb files
    [Beehive_Monitor_main_PCB.kicad_pcb, Beehive_Monitor_main_PCB.kicad_sch]
2025-03-25 mcu analogue pins doc added
    [Pin Mappings.xlsx]
2025-03-26 copy files
    [Beehive_Monitor_main_PCB-B_Mask.gbr, Beehive_Monitor_main_PCB-B_Paste.gbr, Beehive_Monitor_main_PCB-B_Silkscreen.gbr, Beehive_Monitor_main_PCB-Edge_Cuts.gbr, Beehive_Monitor_main_PCB-F_Cu.gbr, Beehive_Monitor_main_PCB-F_Mask.gbr, Beehive_Monitor_main_PCB-F_Paste.gbr, Beehive_Monitor_main_PCB-F_Silkscreen.gbr]
2025-04-06 Create detect_or_track_bee_pollen_logging
    Tracks and logs bees movement + wasps + Pollen Clustering using K Means (Currently CSV Output)
2025-04-13 Dual Camera test
2025-04-24 Update and rename thread_1_cam.py to thread_1_cam_v1.py
